zeyadhost/verispeed/pcb-v2/3dmodels/Alps_EC11E-05SW.step

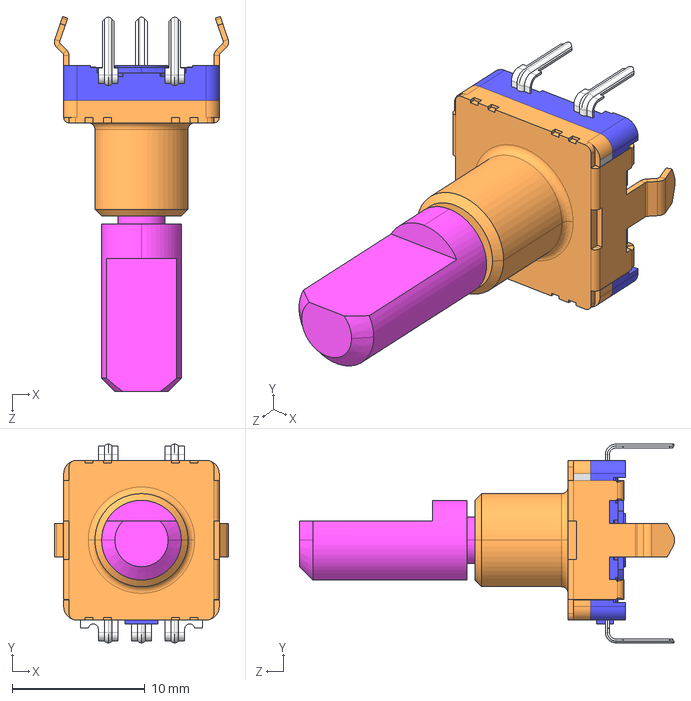
[picture p4: CAD file, 2026-11-10]
pcb-v2/3dmodels/Alps_EC11E-05SW.step
13.1 x 15.0 x 28.2 mm
