zeyadhost/verispeed/pcb-v2/3dmodels/Waveshare_2inch_LCD_Module.step

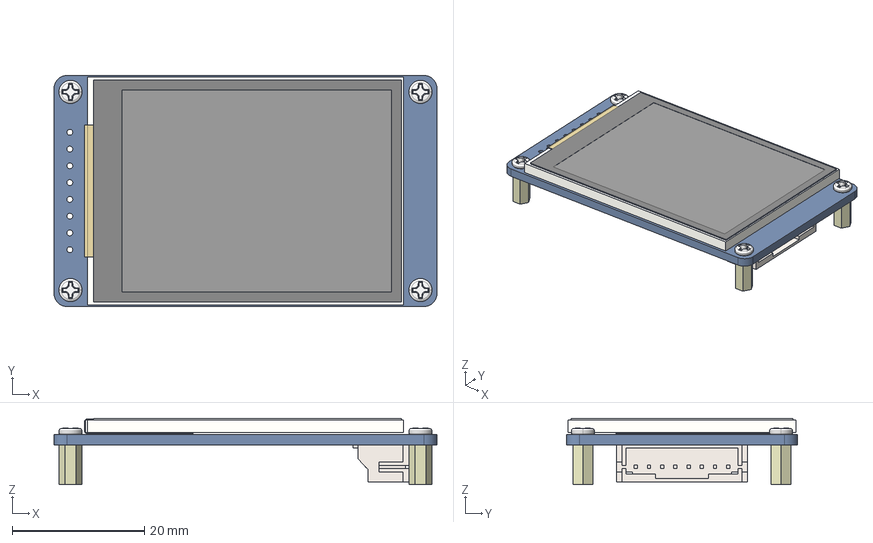
[picture p5: CAD file, 2026-11-10]
pcb-v2/3dmodels/Waveshare_2inch_LCD_Module.step
58.0 x 35.0 x 10.0 mm
2INCH-240X320-LCD
2INCH-LCD-MODULE-PCBA
HEX_STUDS-M2XH6 x 4
PM2X5-SCREW x 4
HP2_0-8PIN-SMT
