zeyadhost/verispeed/pcb/audio.step

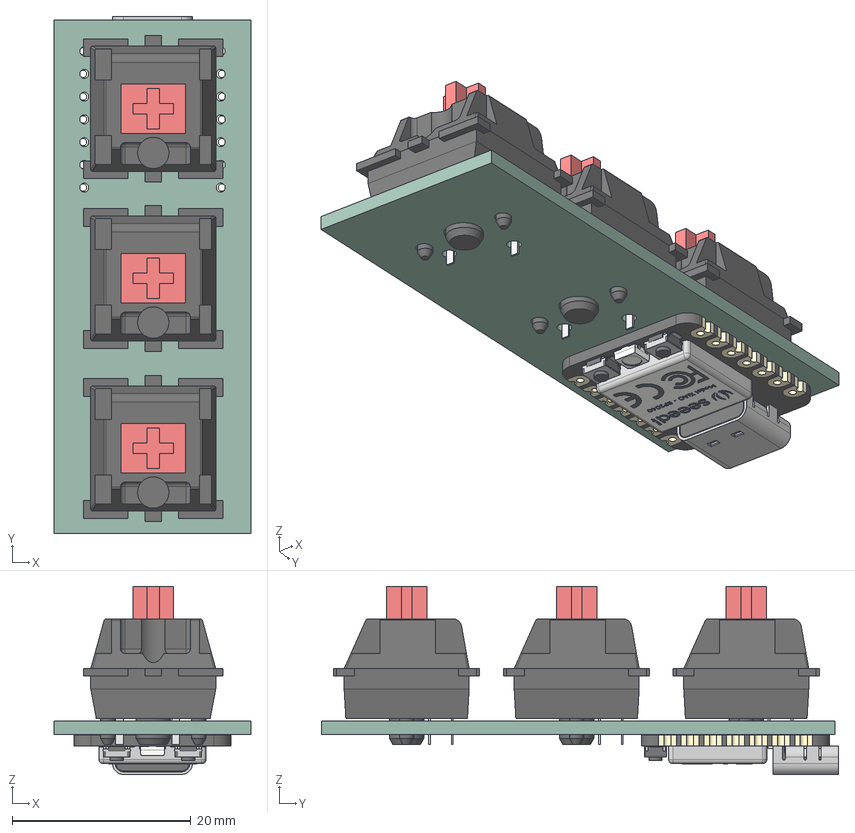
[picture p6: CAD file, 2026-10-17, an earlier design]
pcb/audio.step
22.0 x 57.8 x 21.0 mm
type-c v2
smd_button v3
DOUT
DIN
VSS
VDD
smd_button v3(Mirror)
audio_PCB
