zeyadhost/verispeed/(list of files, cad)

Other CAD files:
case/verispeed_case.f3d
case/verispeed_pcb_model.f3d
