zeyadhost/verispeed/pcb-v2/audio.kicad_pcb

## KiCad design pcb-v2/audio.kicad_pcb (2026-11-10)

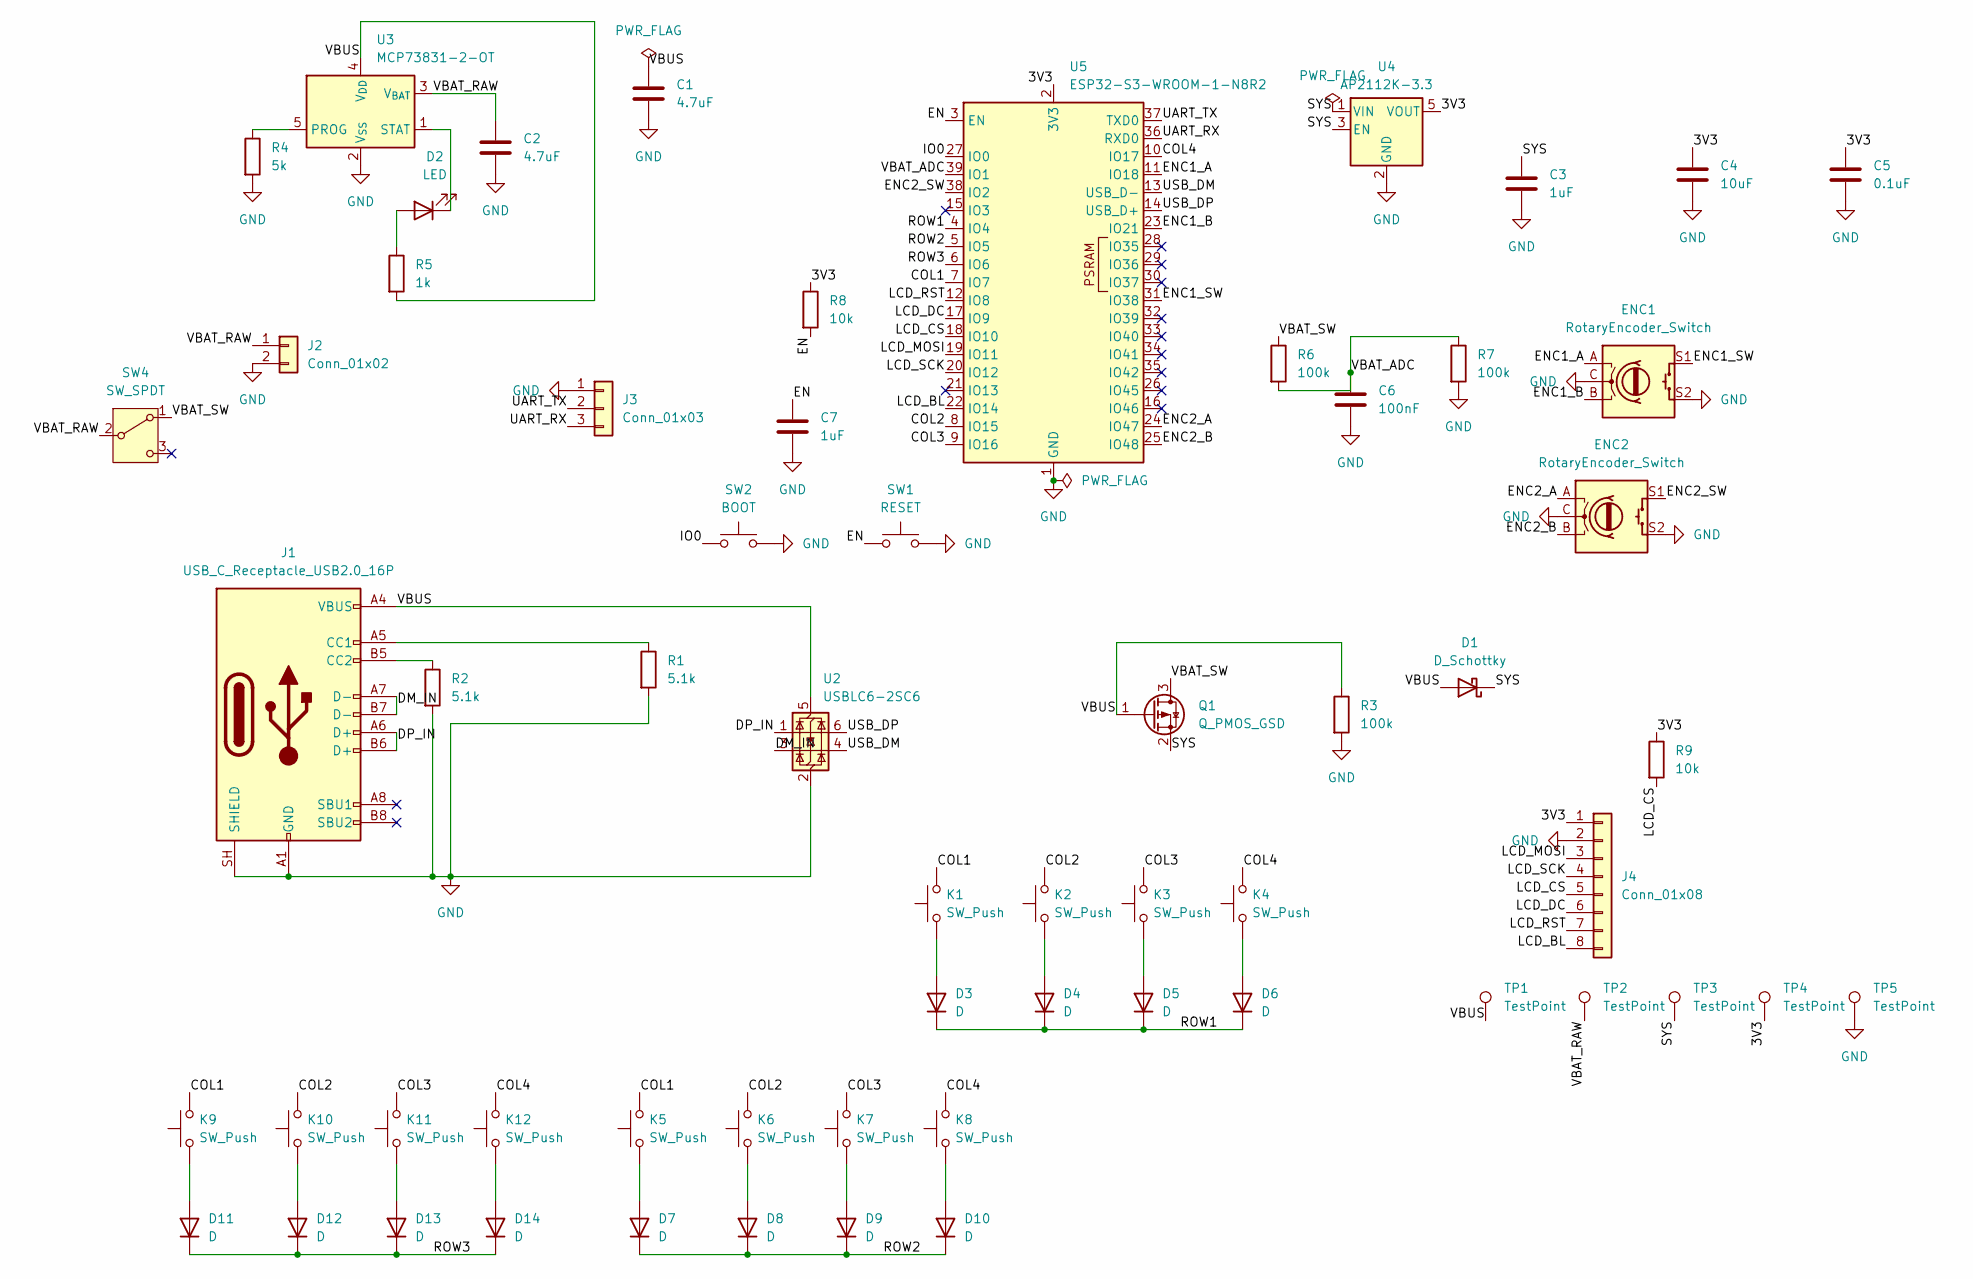
[picture p7: schematic audio.kicad_sch, Varispeed]

Parts:
C1, C2: 4.7uF; C_0805_2012Metric_Pad1.18x1.45mm_HandSolder
C3, C7: 1uF; C_0603_1608Metric_Pad1.08x0.95mm_HandSolder
C4: 10uF; C_0805_2012Metric_Pad1.18x1.45mm_HandSolder
C5: 0.1uF; C_0603_1608Metric_Pad1.08x0.95mm_HandSolder
C6: 100nF; C_0603_1608Metric_Pad1.08x0.95mm_HandSolder
D1: D_Schottky; D_SMA
D2: LED; LED_0603_1608Metric_Pad1.05x0.95mm_HandSolder
D3, D4, D5, D6, D7, D8, D9, D10, D11, D12, D13, D14: D; D_SOD-123
ENC1, ENC2: RotaryEncoder_Switch; RotaryEncoder_Alps_EC11E15244G1_Vertical
J1: USB_C_Receptacle_USB2.0_16P; USB_C_Receptacle_GCT_USB4085_FinePitch
J2: Conn_01x02; JST_PH_B2B-PH-K_1x02_P2.00mm_Vertical
J3: Conn_01x03; PinHeader_1x03_P2.54mm_Vertical
J4: Conn_01x08; Waveshare_2inch_LCD_Module
K1, K2, K3, K4, K5, K6, K7, K8, K9, K10, K11, K12: SW_Push; SW_Cherry_MX_1.00u_PCB
Q1: Q_PMOS_GSD; SOT-23
R1, R2: 5.1k; R_0603_1608Metric_Pad0.98x0.95mm_HandSolder
R3, R6, R7: 100k; R_0603_1608Metric_Pad0.98x0.95mm_HandSolder
R4: 5k; R_0603_1608Metric_Pad0.98x0.95mm_HandSolder
R5: 1k; R_0603_1608Metric_Pad0.98x0.95mm_HandSolder
R8, R9: 10k; R_0603_1608Metric_Pad0.98x0.95mm_HandSolder
SW1: RESET; SW_TH_Tactile_Omron_B3F-100x
SW2: BOOT; SW_TH_Tactile_Omron_B3F-100x
SW4: SW_SPDT; SW_Slide_SPDT_Angled_GSwitch_SK-12D02
TP1, TP2, TP3, TP4, TP5: TestPoint; TestPoint_Pad_D2.0mm
U2: USBLC6-2SC6; SOT-23-6
U3: MCP73831-2-OT; SOT-23-5
U4: AP2112K-3.3; SOT-23-5
U5: ESP32-S3-WROOM-1-N8R2; ESP32-S3-WROOM-1_Via0.3mm

Connections:
/3V3: C4.1, C5.1, J4.1, R8.1, R9.1, TP4.1 (1_1), U4.5 (VOUT), U5.2 (3V3)
/COL1: K1.2, K5.2, K9.2, U5.7 (IO7)
/COL2: K2.2, K6.2, K10.2, U5.8 (IO15)
/COL3: K3.2, K7.2, K11.2, U5.9 (IO16)
/COL4: K4.2, K8.2, K12.2, U5.10 (IO17)
/DM_IN: J1.A7 (D-), J1.B7 (D-), U2.3 (I/O2)
/DP_IN: J1.A6 (D+), J1.B6 (D+), U2.1 (I/O1)
/EN: C7.1, R8.2, SW1.1, U5.3 (EN)
/ENC1_A: ENC1.A, U5.11 (IO18)
/ENC1_B: ENC1.B, U5.23 (IO21)
/ENC1_SW: ENC1.S1, U5.31 (IO38)
/ENC2_A: ENC2.A, U5.24 (IO47)
/ENC2_B: ENC2.B, U5.25 (IO48)
/ENC2_SW: ENC2.S1, U5.38 (IO2)
/IO0: SW2.1, U5.27 (IO0)
/LCD_BL: J4.8, U5.22 (IO14)
/LCD_CS: J4.5, R9.2, U5.18 (IO10)
/LCD_DC: J4.6, U5.17 (IO9)
/LCD_MOSI: J4.3, U5.19 (IO11)
/LCD_RST: J4.7, U5.12 (IO8)
/LCD_SCK: J4.4, U5.20 (IO12)
/ROW1: D3.1 (K), D4.1 (K), D5.1 (K), D6.1 (K), U5.4 (IO4)
/ROW2: D7.1 (K), D8.1 (K), D9.1 (K), D10.1 (K), U5.5 (IO5)
/ROW3: D11.1 (K), D12.1 (K), D13.1 (K), D14.1 (K), U5.6 (IO6)
/SYS: C3.1, D1.1 (K), Q1.2 (S), TP3.1 (1_1), U4.1 (VIN), U4.3 (EN)
/UART_RX: J3.3, U5.36 (RXD0)
/UART_TX: J3.2, U5.37 (TXD0)
/USB_DM: U2.4 (I/O2), U5.13 (USB_D-)
/USB_DP: U2.6 (I/O1), U5.14 (USB_D+)
/VBAT_ADC: C6.1, R6.2, R7.1, U5.39 (IO1)
/VBAT_RAW: C2.1, J2.1, SW4.2 (B), TP2.1 (1_1), U3.3 (V_{BAT})
/VBAT_SW: Q1.3 (D), R6.1, SW4.1 (A)
/VBUS: C1.1, D1.2 (A), J1.A4 (VBUS), J1.A9 (VBUS), J1.B4 (VBUS), J1.B9 (VBUS), Q1.1 (G), R3.1, R5.2, TP1.1 (1_1), U2.5 (VBUS), U3.4 (V_{DD})
GND: C1.2, C2.2, C3.2, C4.2, C5.2, C6.2, C7.2, ENC1.C, ENC1.S2, ENC2.C, ENC2.S2, J1.A1 (GND), J1.A12 (GND), J1.B1 (GND), J1.B12 (GND), J1.SH (SHIELD), J2.2, J3.1, J4.2, R1.2, R2.2, R3.2, R4.2, R7.2, SW1.2, SW2.2, TP5.1 (1_1), U2.2 (GND), U3.2 (V_{SS}), U4.2 (GND), U5.1 (GND), U5.40 (GND), U5.41 (GND)
unnamed: D2.2 (A), R5.1
unnamed: D2.1 (K), U3.1 (STAT)
unnamed: D3.2 (A), K1.1
unnamed: D4.2 (A), K2.1
unnamed: D5.2 (A), K3.1
unnamed: D6.2 (A), K4.1
unnamed: D7.2 (A), K5.1
unnamed: D8.2 (A), K6.1
unnamed: D9.2 (A), K7.1
unnamed: D10.2 (A), K8.1
unnamed: D11.2 (A), K9.1
unnamed: D12.2 (A), K10.1
unnamed: D13.2 (A), K11.1
unnamed: D14.2 (A), K12.1
unnamed: J1.A5 (CC1), R1.1
unnamed: J1.B5 (CC2), R2.1
unnamed: R4.1, U3.5 (PROG)

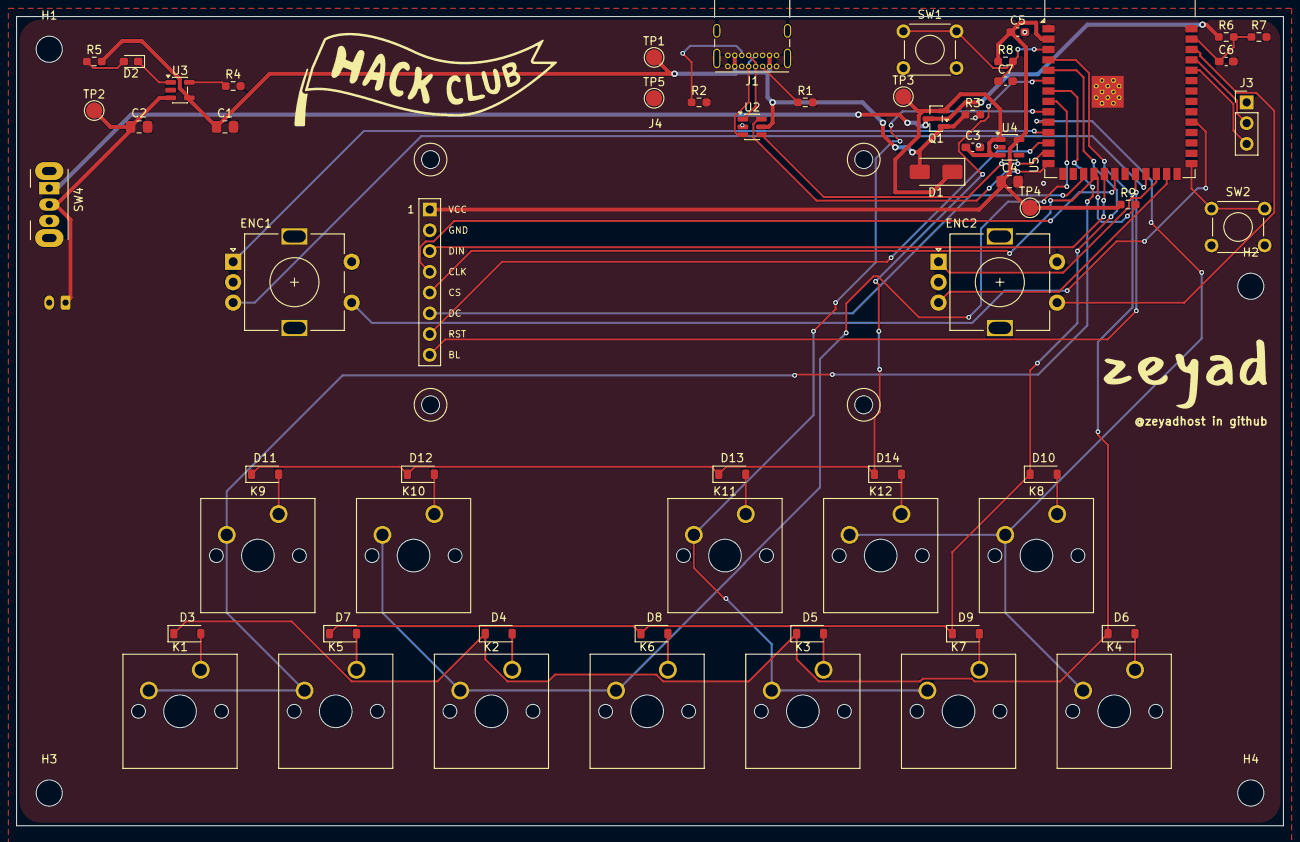
[picture p8: board pcb-v2/audio.kicad_pcb from above]

Board: 2 copper layers, 155.0 x 99.0 mm, 65 parts (1 on the bottom side), 51 nets.

Other parts of the board:
H1, H2, H3, H4: MountingHole_3.2mm_M3
