zeyadhost/verispeed/pcb/audio.kicad_pcb

## KiCad design pcb/audio.kicad_pcb (2026-10-17, an earlier design)

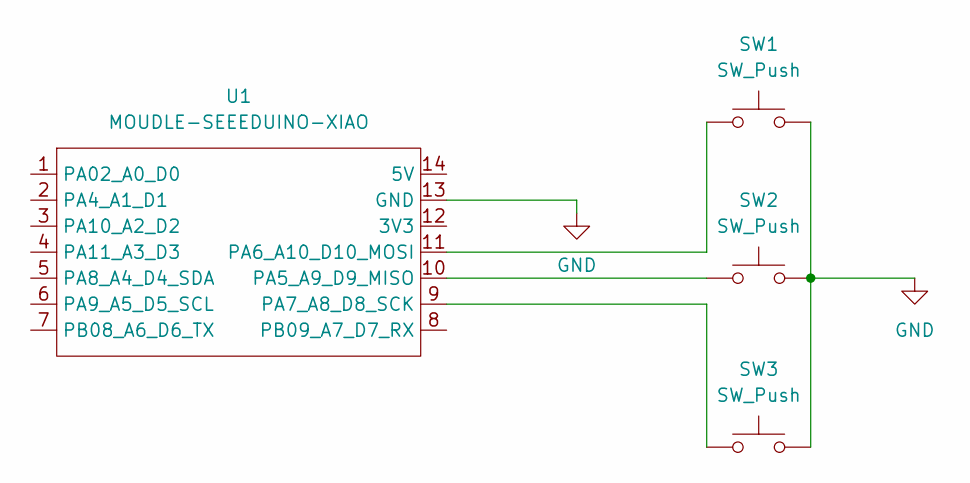
[picture p9: schematic audio.kicad_sch]

Parts:
SW1, SW2, SW3: SW_Push; SW_Cherry_MX_1.00u_PCB
U1: MOUDLE-SEEEDUINO-XIAO; XIAO-Generic-Hybrid-14P-2.54-21X17.8MM

Connections:
GND: SW1.2, SW2.2, SW3.2, U1.13 (GND)
unnamed: SW2.1, U1.10 (PA5_A9_D9_MISO)
unnamed: SW1.1, U1.11 (PA6_A10_D10_MOSI)
unnamed: SW3.1, U1.9 (PA7_A8_D8_SCK)

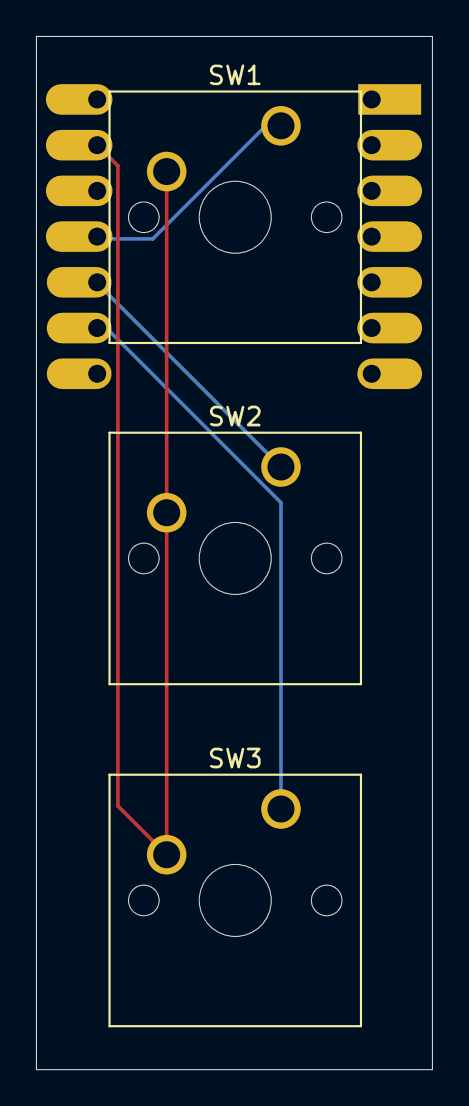
[picture p10: board pcb/audio.kicad_pcb from above]

Board: 2 copper layers, 22.0 x 57.4 mm, 4 parts (1 on the bottom side), 4 nets.
