zeyadhost/verispeed/(commit log)

2026-10-16 Initial commit: Verispeed 3-key macropad
    KiCad PCB project, Fusion 360 case, and symbol/footprint libraries
    for the XIAO RP2040-based Verispeed macropad.
    [audio.kicad_pcb, audio.kicad_sch, verispeed_case.f3d]
2026-10-16 Tidy .gitignore and drop local KiCad UI state
2026-10-16 Add case and PCB renders
2026-10-16 Widen the PCB outline to 22 mm and update the case model.
    [audio.kicad_pcb, verispeed_case.f3d]
2026-10-17 Add the final 3D models and make the PCB model paths relative.
    [audio.kicad_pcb, audio.step, verispeed_case.f3d, verispeed_pcb_model.f3d]
2026-10-17 Add the firmware and case alignment journal entry.
2026-10-18 Ignore the handout and add the version 2 schematic.
    Add HANDOUT.md to .gitignore and stop tracking it. The file stays on disk.
    Add the first version 2 schematic in pcb-v2/. It has the power block: USB-C, battery charger, power switch, and 3.3 V regulator.
    [audio.kicad_sch]
2026-10-18 Add the power schematic journal entry.
2026-10-18 Add the images to the power schematic journal entry.
    Add three images for the power schematic entry: two schematic screenshots and the 3D model of the Waveshare display.
2026-11-10 Add the version 2 KiCad project and its footprint library.
    [audio.kicad_pcb, audio.kicad_sch]
2026-11-10 Add the 3D models for the encoder and the screen.
    [Alps_EC11E-05SW.step, Waveshare_2inch_LCD_Module.step]
2026-11-10 Add the silkscreen art files for the flag and the signature.
2026-11-10 Add the pictures of the finished board.
2026-11-10 Write a new README for the board.
2026-11-10 Add the PCB journal entry.
2026-11-10 Say in the README that the board is a MIDI device for a laptop.
